Vishal-Mutha/ESP32-S3-FOC-for-BLDC/FOC_STEP.step

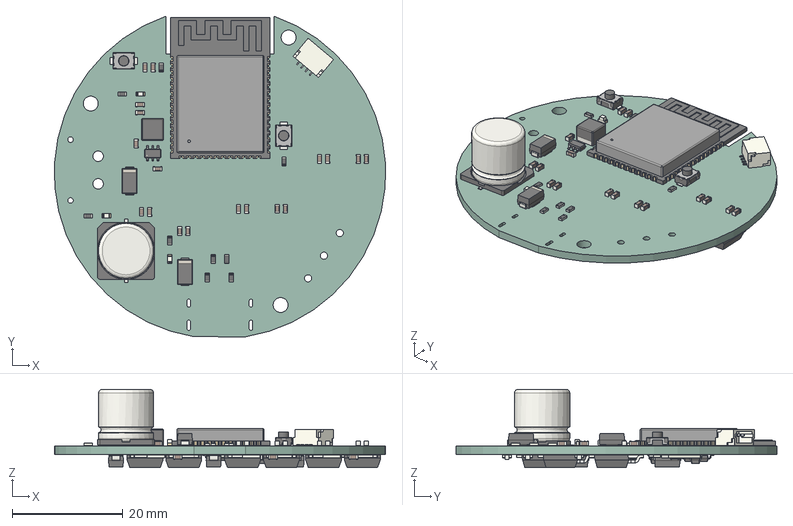
[picture p10: CAD file, 2026-09-08]
FOC_STEP.step
59.9 x 58.0 x 14.2 mm
C_0603_1608Metric x 29
D_SMA x 5
ESP32-S3-WROOM-1
SW_SPST_TS-1088-xR025 x 2
R_0603_1608Metric x 27
LED_0603_1608Metric x 3
JST_SH_SM04B-SRSS-TB_1x04-1MP_P1.00mm_Horizontal
L_APV_ANR4030
TSOT-23-6
C_Elec_10x102
R_2512_6332Metric x 3
932d09b3-9c39-11ed-93f0-dde97e994e83_part x 6
932d09b4-9c39-11ed-93f0-dde97e994e83_part x 6
932d09b5-9c39-11ed-93f0-dde97e994e83_part x 6
SOT-23-6 x 3
R_1206_3216Metric x 3
TSSOP-20_4.4x6.5mm_P0.65mm
TSSOP-14_4.4x5mm_P0.65mm
FOC-driver_PCB
