Vishal-Mutha/ESP32-S3-FOC-for-BLDC/components/10155679-00031LF/10155679-00031LF.step

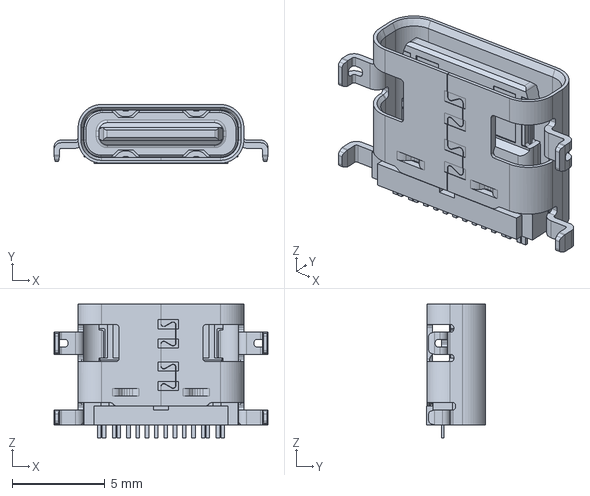
[picture p11: CAD file, 2026-09-08]
components/10155679-00031LF/10155679-00031LF.step
11.5 x 3.18 x 7.20 mm
