Vishal-Mutha/ESP32-S3-FOC-for-BLDC/(list of files, cad)

Other CAD files:
FOC - Sketch 1.dwg
