Vishal-Mutha/ESP32-S3-FOC-for-BLDC/FOC-driver.pdf

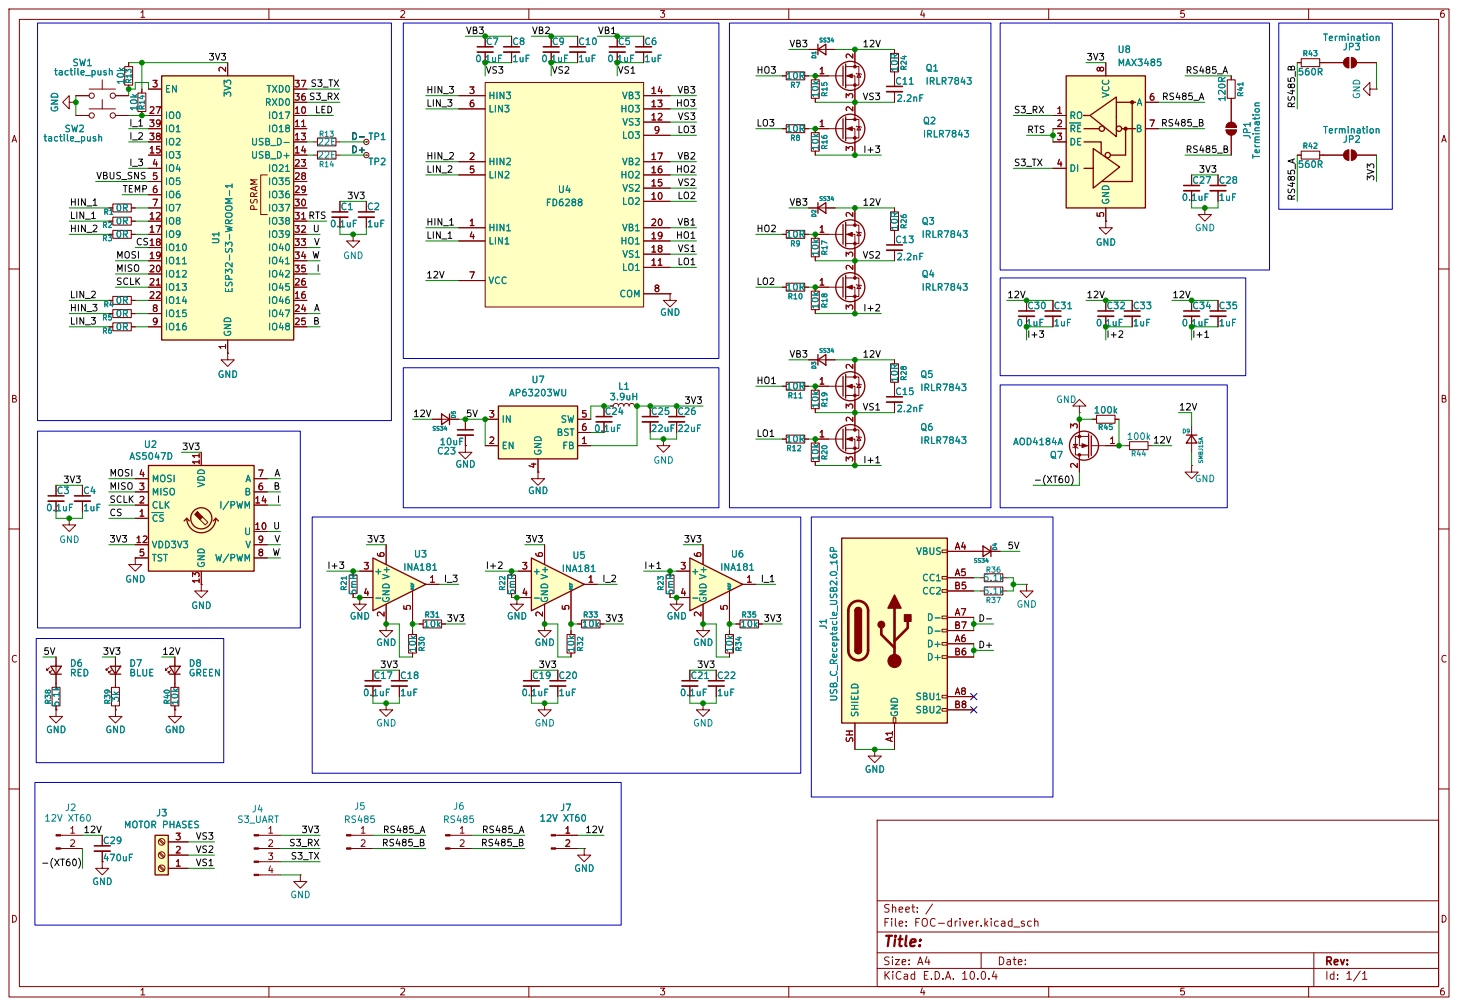
[picture p12: page 1]

Size: A4 | Rev:
KiCad E.D.A. 10.0.4 | Id: 1/1
