Vishal-Mutha/ESP32-S3-FOC-for-BLDC/FOC-driver.kicad_pcb

## KiCad design FOC-driver.kicad_pcb (2026-09-08)

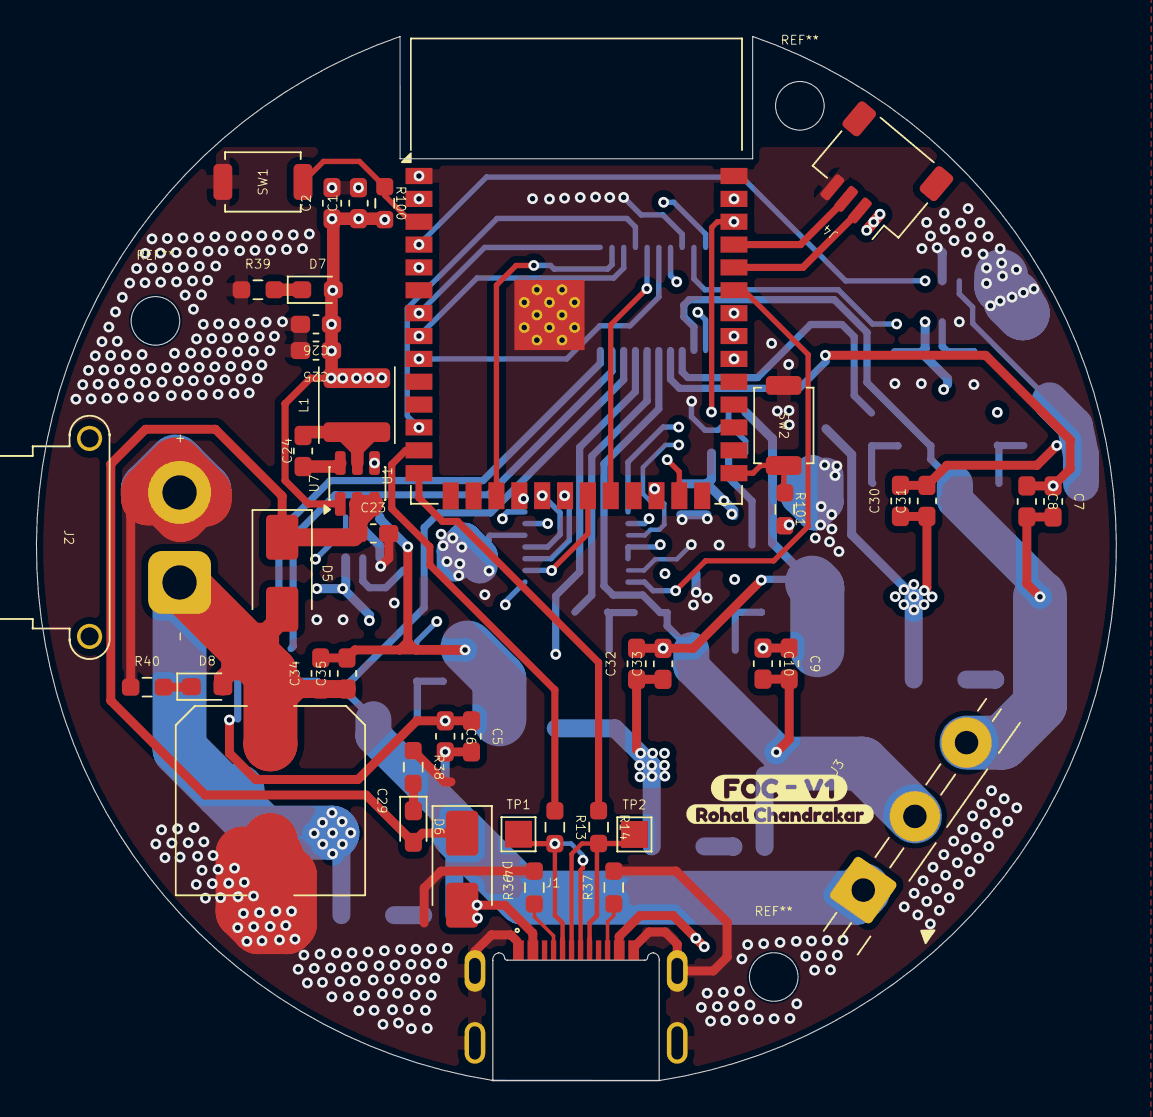
[picture p13: board FOC-driver.kicad_pcb from above]

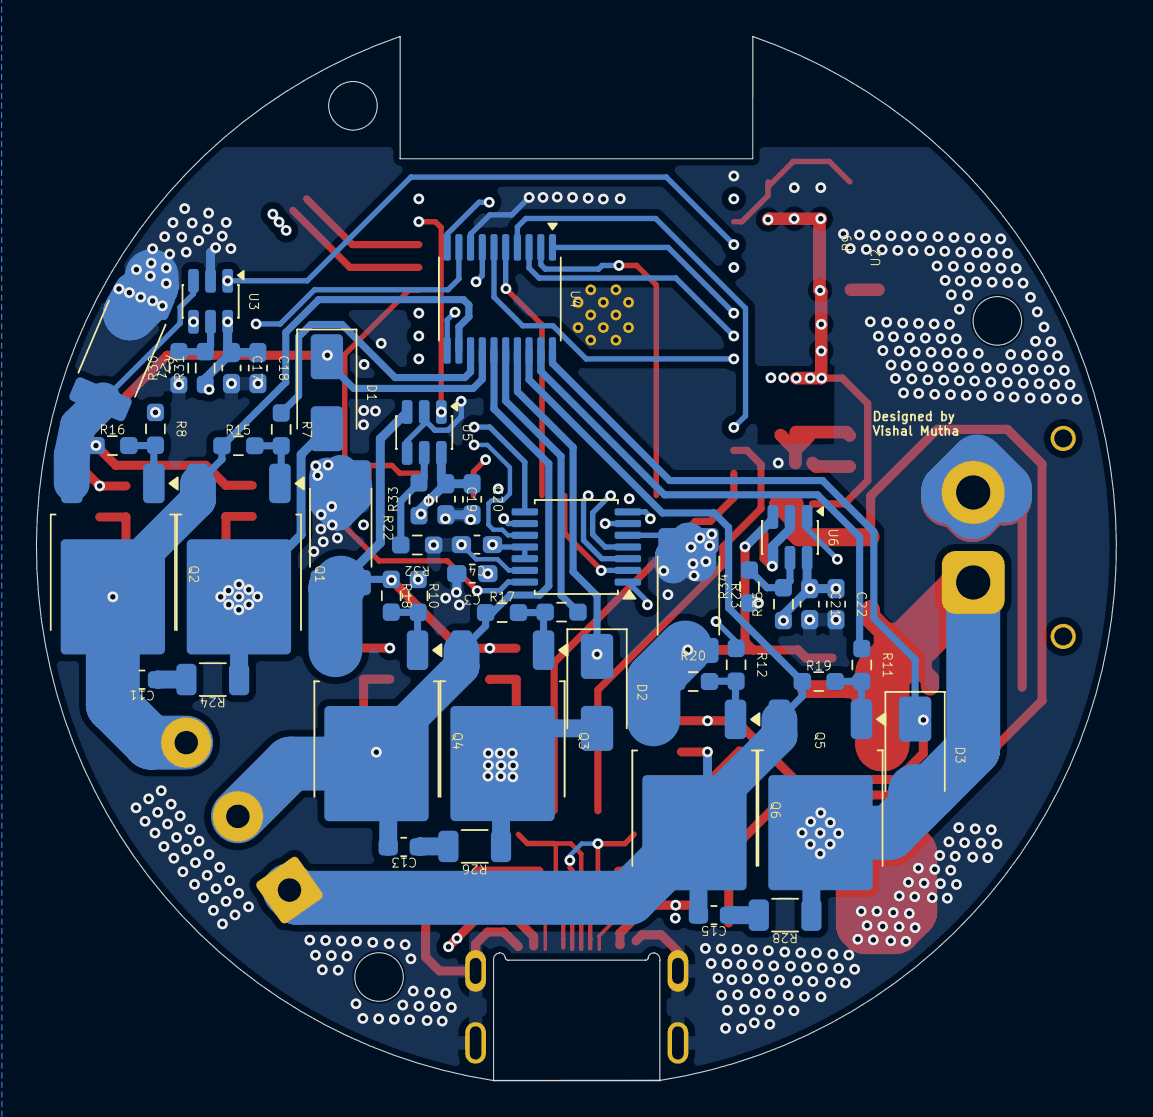
[picture p14: board FOC-driver.kicad_pcb from below]

Board: 4 copper layers, 60.0 x 58.0 mm, 95 parts (49 on the bottom side), 66 nets.

Parts:
C1, C3, C5, C7, C9, C17, C19, C21, C24, C30, C32, C34: 0.1uF; C_0603_1608Metric_Pad1.08x0.95mm_HandSolder
C2, C4, C6, C8, C10, C18, C20, C22, C31, C33, C35: 1uF; C_0603_1608Metric_Pad1.08x0.95mm_HandSolder
C11, C13, C15: 2.2nF; C_0603_1608Metric_Pad1.08x0.95mm_HandSolder
C23: 10uF; C_0603_1608Metric_Pad1.08x0.95mm_HandSolder
C25, C26: 22uF; C_0603_1608Metric_Pad1.08x0.95mm_HandSolder
C29: 470uF; C_Elec_10x10.2
D1, D2, D3, D4, D5: SS34; D_SMA
D6: RED; LED_0603_1608Metric_Pad1.05x0.95mm_HandSolder
D7: BLUE; LED_0603_1608Metric_Pad1.05x0.95mm_HandSolder
D8: GREEN; LED_0603_1608Metric_Pad1.05x0.95mm_HandSolder
J1: USB_C_Receptacle_USB2.0_16P; AMPHENOL_10155679-00031LF
J2: 12V XT60; AMASS_XT30PW-F_1x02_P2.50mm_Horizontal
J3: MOTOR PHASES; TerminalBlock_MaiXu_MX126-5.0-03P_1x03_P5.00mm
J4: S3_UART; JST_SH_SM04B-SRSS-TB_1x04-1MP_P1.00mm_Horizontal
L1: 3.9uH; L_APV_ANR4030
Q1, Q2, Q3, Q4, Q5, Q6: IRLR7843; TO-252-2
R7, R8, R9, R10, R11, R12: 10R; R_0603_1608Metric_Pad0.98x0.95mm_HandSolder
R13, R14: 22E; R_0603_1608Metric_Pad0.98x0.95mm_HandSolder
R15, R16, R17, R18, R19, R20, R30, R31, R32, R33, R34, R35, R40, R100, R101: 10k; R_0603_1608Metric_Pad0.98x0.95mm_HandSolder
R21, R22, R23: 5mR; R_2512_6332Metric_Pad1.40x3.35mm_HandSolder
R24, R26, R28: 10R; R_1206_3216Metric
R36, R37, R38: 5.1k; R_0603_1608Metric_Pad0.98x0.95mm_HandSolder
R39: 3k; R_0603_1608Metric_Pad0.98x0.95mm_HandSolder
SW1, SW2: tactile_push; SW_SPST_TS-1088-xR025
TP1: D-; TestPoint_Pad_1.5x1.5mm
TP2: D+; TestPoint_Pad_1.5x1.5mm
U1: ESP32-S3-WROOM-1
U2: AS5047D; TSSOP-14_4.4x5mm_P0.65mm
U3, U5, U6: INA181; SOT-23-6
U4: FD6288; TSSOP-20_4.4x6.5mm_P0.65mm
U7: AP63203WU; TSOT-23-6
kibuzzard-6A9D1F00: G***; kibuzzard-6A9D1F00
kibuzzard-6A9D1F23: G***; kibuzzard-6A9D1F23

Connections:
/3V3: C1.1, C2.1, C3.1, C4.1, C17.1, C18.1, C19.1, C20.1, C21.1, C22.1, C25.1, C26.1, D7.2 (A), J4.1, L1.2, R31.1, R33.1, R35.1, R100.2, R101.2, U1.2 (3V3), U2.11 (VDD), U2.12 (VDD3V3), U3.6 (V+), U5.6 (V+), U6.6 (V+), U7.1 (FB)
/5V: C23.1, D4.1 (K), D5.1 (K), D6.2 (A), U7.2 (EN), U7.3 (IN)
/12V: C29.1, C30.1, C31.1, C32.1, C33.1, C34.1, C35.1, D1.2 (A), D2.2 (A), D3.2 (A), D5.2 (A), D8.2 (A), J2.1, Q1.2 (D), Q3.2 (D), Q5.2 (D), R24.2, R26.2, R28.2, U4.7 (VCC)
/A: U1.24 (IO47), U2.7 (A)
/B: U1.25 (IO48), U2.6 (B)
/CS: U1.18 (IO10), U2.1 (~CS)
/D+: J1.A6 (D+), J1.B6 (D+), R14.2, TP2.1 (1_1)
/D-: J1.A7 (D-), J1.B7 (D-), R13.2, TP1.1 (1_1)
/HIN_1: U1.7 (IO7), U4.1 (HIN1)
/HIN_2: U1.17 (IO9), U4.2 (HIN2)
/HIN_3: U1.8 (IO15), U4.3 (HIN3)
/HO1: R11.1, U4.19 (HO1)
/HO2: R9.1, U4.16 (HO2)
/HO3: R7.1, U4.13 (HO3)
/I: U1.35 (IO42), U2.14 (I/PWM)
/I+1: C34.2, C35.2, Q6.3 (S), R20.1, R23.2, U6.3 (+)
/I+2: C32.2, C33.2, Q4.3 (S), R18.1, R22.2, U5.3 (+)
/I+3: C30.2, C31.2, Q2.3 (S), R16.1, R21.2, U3.3 (+)
/I_1: U1.39 (IO1), U6.1
/I_2: U1.38 (IO2), U5.1
/I_3: U1.4 (IO4), U3.1
/LIN_1: U1.12 (IO8), U4.4 (LIN1)
/LIN_2: U1.22 (IO14), U4.5 (LIN2)
/LIN_3: U1.9 (IO16), U4.6 (LIN3)
/LO1: R12.1, U4.11 (LO1)
/LO2: R10.1, U4.10 (LO2)
/LO3: R8.1, U4.9 (LO3)
/MISO: U1.20 (IO12), U2.3 (MISO)
/MOSI: U1.19 (IO11), U2.4 (MOSI)
/S3_RX: J4.2, U1.36 (RXD0)
/S3_TX: J4.3, U1.37 (TXD0)
/SCLK: U1.21 (IO13), U2.2 (CLK)
/U: U1.32 (IO39), U2.10 (U)
/V: U1.33 (IO40), U2.9 (V)
/VB1: C5.1, C6.1, D3.1 (K), U4.20 (VB1)
/VB2: C9.1, C10.1, D2.1 (K), U4.17 (VB2)
/VB3: C7.1, C8.1, D1.1 (K), U4.14 (VB3)
/VS1: C5.2, C6.2, C15.2, J3.1, Q5.3 (S), Q6.2 (D), R19.1, U4.18 (VS1)
/VS2: C9.2, C10.2, C13.2, J3.2, Q3.3 (S), Q4.2 (D), R17.1, U4.15 (VS2)
/VS3: C7.2, C8.2, C11.2, J3.3, Q1.3 (S), Q2.2 (D), R15.1, U4.12 (VS3)
/W: U1.34 (IO41), U2.8 (W/PWM)
GND: C1.2, C2.2, C3.2, C4.2, C17.2, C18.2, C19.2, C20.2, C21.2, C22.2, C23.2, C25.2, C26.2, C29.2, J1.A1 (GND), J1.B1 (GND), J1.SH (SHIELD), J2.2, J4.4, R21.1, R22.1, R23.1, R30.1, R32.1, R34.1, R36.2, R37.2, R38.1, R39.1, R40.1, SW1.1, SW2.1, U1.1 (GND), U1.40 (GND), U1.41 (GND), U2.5 (TST), U2.13 (GND), U3.2 (GND), U3.4 (-), U4.8 (COM), U5.2 (GND), U5.4 (-), U6.2 (GND), U6.4 (-), U7.4 (GND)
unnamed: C11.1, R24.1
unnamed: C13.1, R26.1
unnamed: C15.1, R28.1
unnamed: D4.2 (A), J1.A4 (VBUS), J1.B4 (VBUS)
unnamed: D6.1 (K), R38.2
unnamed: D7.1 (K), R39.2
unnamed: D8.1 (K), R40.2
unnamed: J1.A5 (CC1), R36.1
unnamed: J1.B5 (CC2), R37.1
unnamed: Q1.1 (G), R7.2, R15.2
unnamed: Q2.1 (G), R8.2, R16.2
unnamed: Q3.1 (G), R9.2, R17.2
unnamed: Q4.1 (G), R10.2, R18.2
unnamed: Q5.1 (G), R11.2, R19.2
unnamed: Q6.1 (G), R12.2, R20.2
unnamed: R100.1, SW1.2, U1.3 (EN)
unnamed: R101.1, SW2.2, U1.27 (IO0)
unnamed: R14.1, U1.14 (USB_D+)
unnamed: R13.1, U1.13 (USB_D-)
unnamed: R30.2, R31.2, U3.5 (REF)
unnamed: R32.2, R33.2, U5.5 (REF)
unnamed: R34.2, R35.2, U6.5 (REF)
unnamed: C24.2, U7.6 (BST)
unnamed: C24.1, L1.1, U7.5 (SW)
